Carlos-Ortega-0/universal-grip-cuff/renders/fusion_viewport.jpg

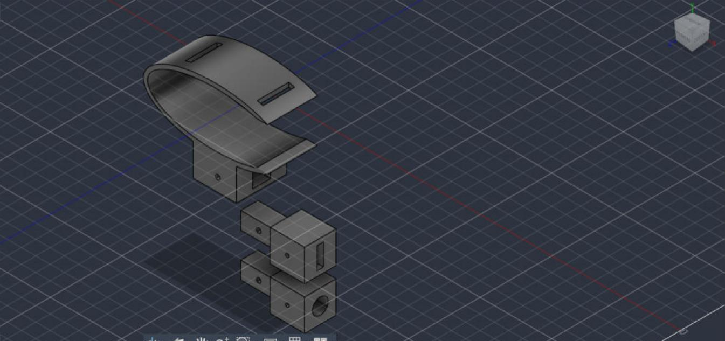
renders/fusion_viewport.jpg
