Carlos-Ortega-0/universal-grip-cuff/cad/step/GripCuff_Size_L.step

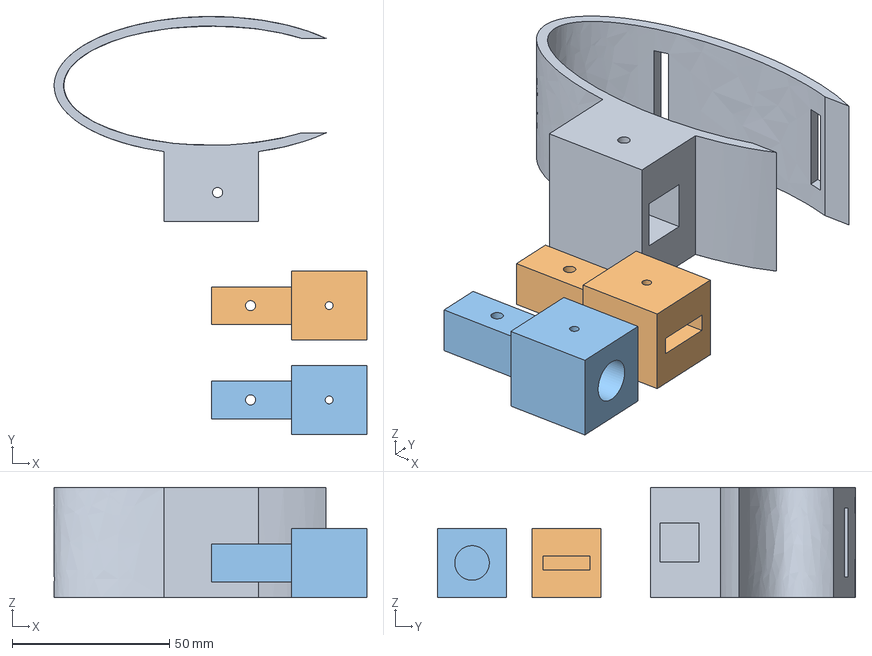
[picture p8: CAD file, 2026-10-14]
cad/step/GripCuff_Size_L.step
99.5 x 133.0 x 35.0 mm
