Carlos-Ortega-0/universal-grip-cuff/stl/size-L/Cuff_L.stl

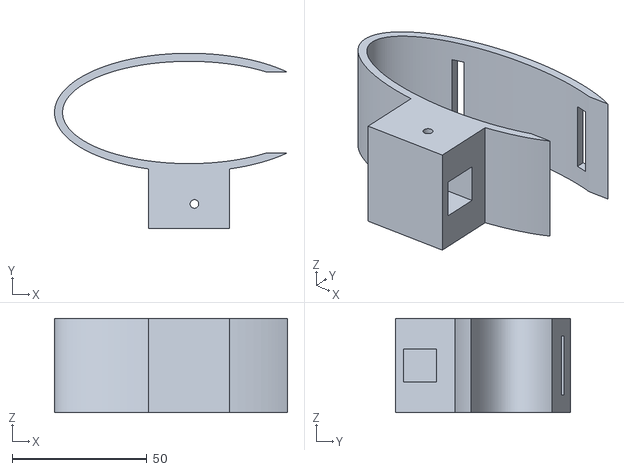
[picture p10: CAD file, 2026-10-14]
stl/size-L/Cuff_L.stl
86.6 x 65.2 x 35.0
