Carlos-Ortega-0/universal-grip-cuff/stl/size-M/Cuff_M.stl

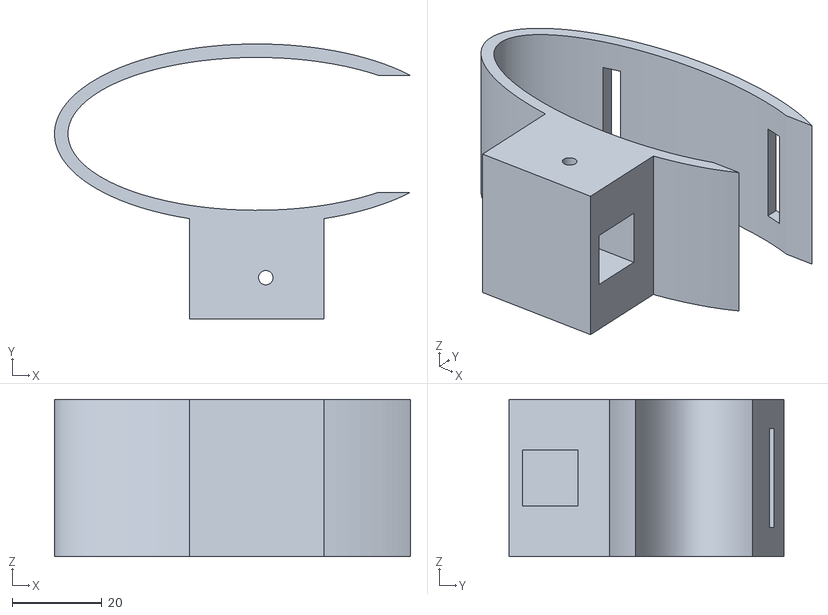
[picture p11: CAD file, 2026-10-14]
stl/size-M/Cuff_M.stl
79.2 x 61.2 x 35.0
