Carlos-Ortega-0/universal-grip-cuff/stl/size-S/Cuff_S.stl

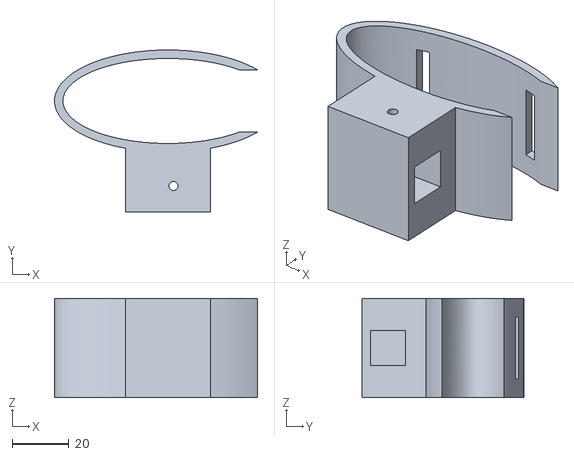
[picture p12: CAD file, 2026-10-14]
stl/size-S/Cuff_S.stl
71.7 x 57.2 x 35.0
