Carlos-Ortega-0/universal-grip-cuff/cad/step/GripCuff_Size_S.step

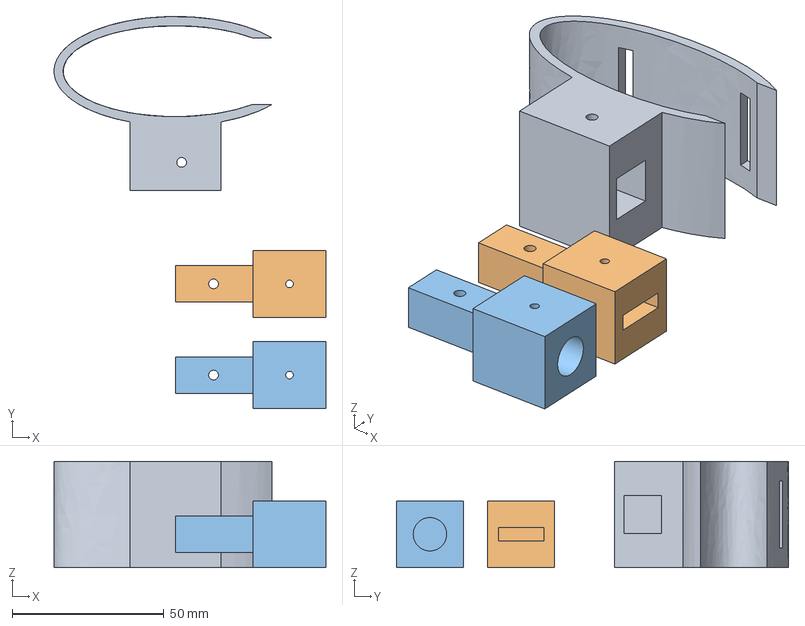
[picture p13: CAD file, 2026-10-14]
cad/step/GripCuff_Size_S.step
89.5 x 129.0 x 35.0 mm
