Carlos-Ortega-0/universal-grip-cuff/stl/adapters/Adapter_Flat.stl

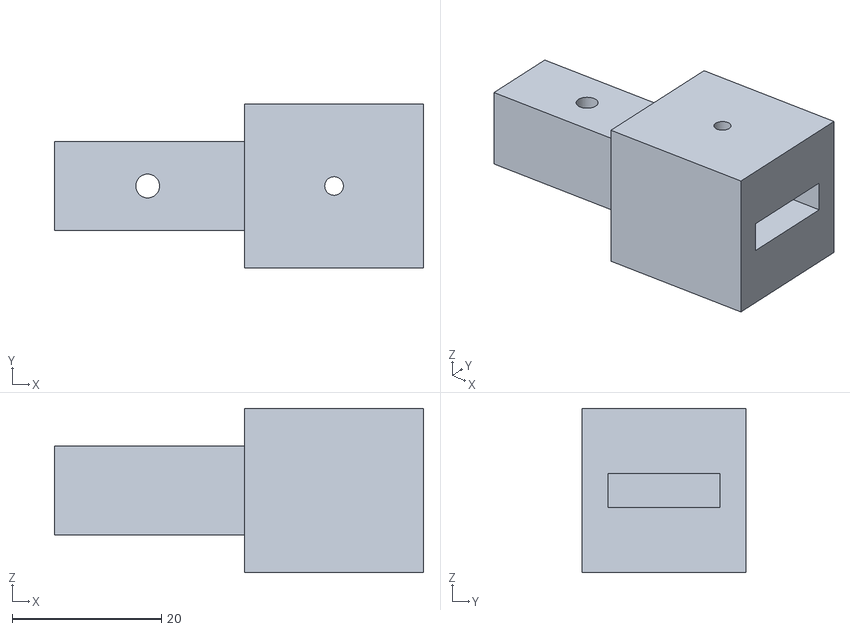
[picture p14: CAD file, 2026-10-14]
stl/adapters/Adapter_Flat.stl
49.5 x 22.0 x 22.0
