Carlos-Ortega-0/universal-grip-cuff/cad/step/GripCuff_Size_M.step

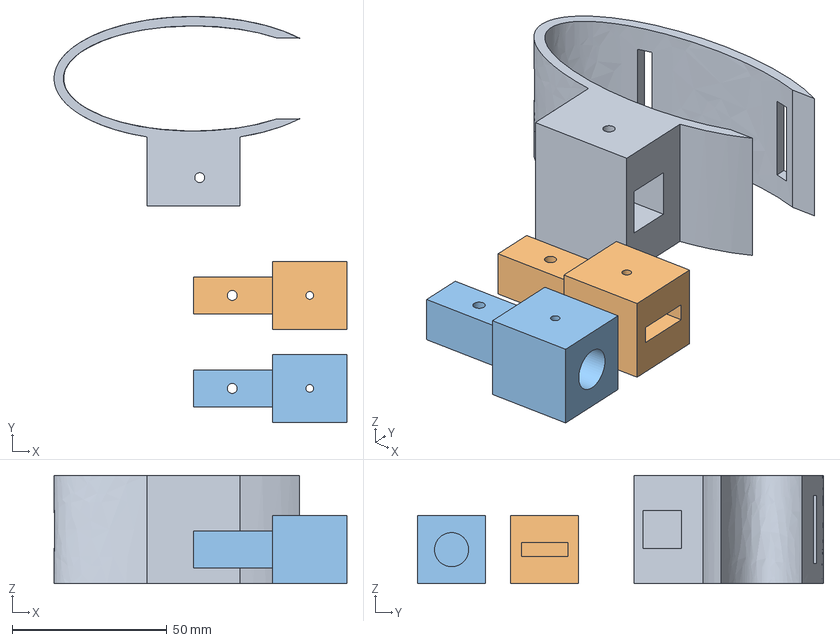
[picture p15: CAD file, 2026-10-14]
cad/step/GripCuff_Size_M.step
94.5 x 131.0 x 35.0 mm
