Carlos-Ortega-0/universal-grip-cuff/(list of files, cad)

Other CAD files:
cad/fusion/GripCuff_Size_L.f3d
cad/fusion/GripCuff_Size_M.f3d
cad/fusion/GripCuff_Size_S.f3d
