Carlos-Ortega-0/universal-grip-cuff/(commit log)

2026-10-14 Add universal grip cuff: Fusion script, CAD, STLs, renders, article
    Parametric Fusion 360 cuff in S/M/L with flat and round quick-swap
    tool adapters. Includes STEP/F3D/STL exports, fit check script,
    design notes and README article.
    Claude-Session: https://claude.ai/code/session_01RS34qzhh4SmKBDnjDCUb7V
    [Adapter_Flat.stl, Adapter_Round.stl, Cuff_L.stl, Cuff_M.stl, Cuff_S.stl, GripCuff_Size_L.f3d, GripCuff_Size_L.step, GripCuff_Size_M.f3d]
2026-10-14 Add hook-and-loop strap slots to cuff
    Two 4 x 22 mm slots in the back wall take a 20 mm strap that crosses
    the back of the hand inside the cuff and closes on the outside. Stops
    the cuff from sliding or spinning. Regenerated all CAD exports, added
    strap routing diagram, back-view render, usage section and a slot
    check in fit_check.py.
    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
    [Cuff_L.stl, Cuff_M.stl, Cuff_S.stl, GripCuff_Size_L.f3d, GripCuff_Size_L.step, GripCuff_Size_M.f3d, GripCuff_Size_M.step, GripCuff_Size_S.f3d]
